am7amamsy/Minesweeper_Competition/README.md

Detection of mines in unexplored environments using a robot controlled via wireless piloting
This repository contains the codes used in detection, actuation, and communication of the robot.

(This project still needs extra documentation)
