am7amamsy/Minesweeper_Competition/Documents/Mega_Shield_Design.PNG

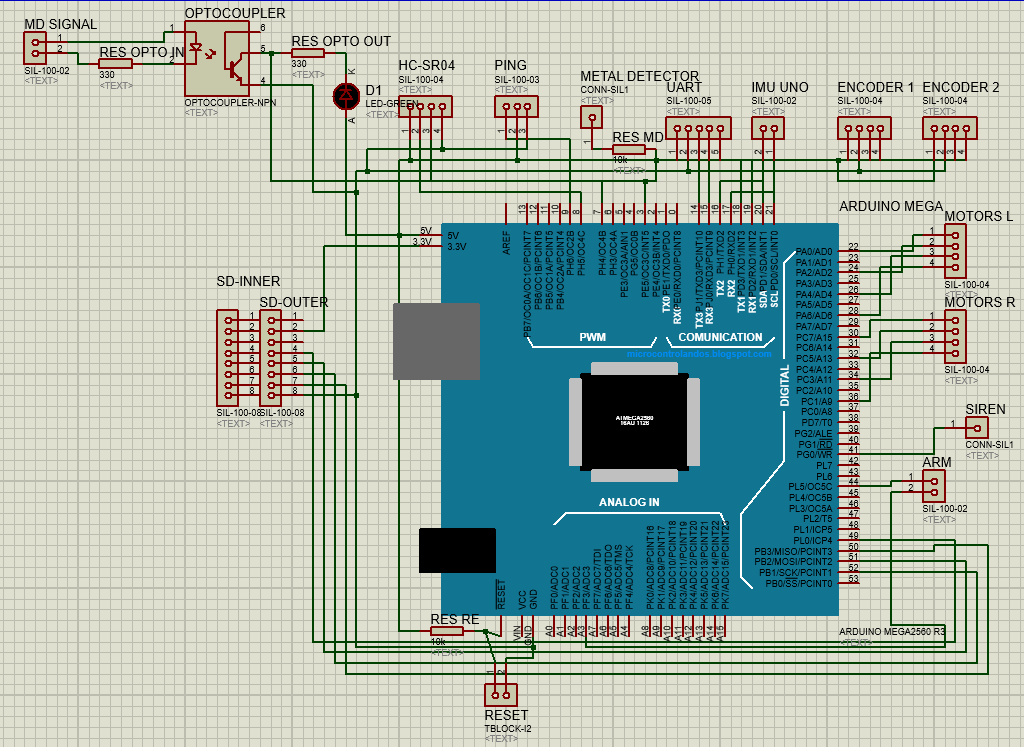
Documents/Mega_Shield_Design.PNG
