am7amamsy/Minesweeper_Competition/Documents/Mega_Shield_PCB.PNG

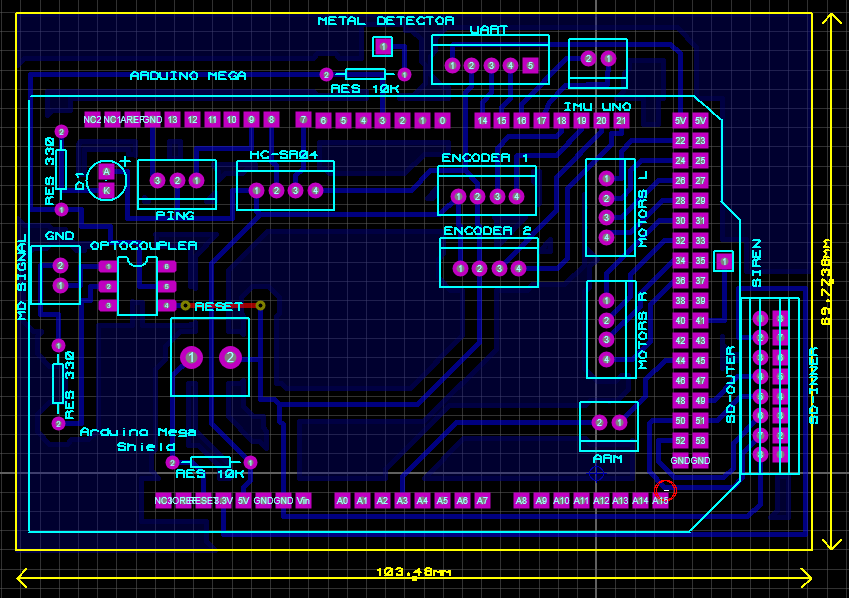
Documents/Mega_Shield_PCB.PNG
