am7amamsy/Minesweeper_Competition/Documents/Metal_Detector_Design.PNG

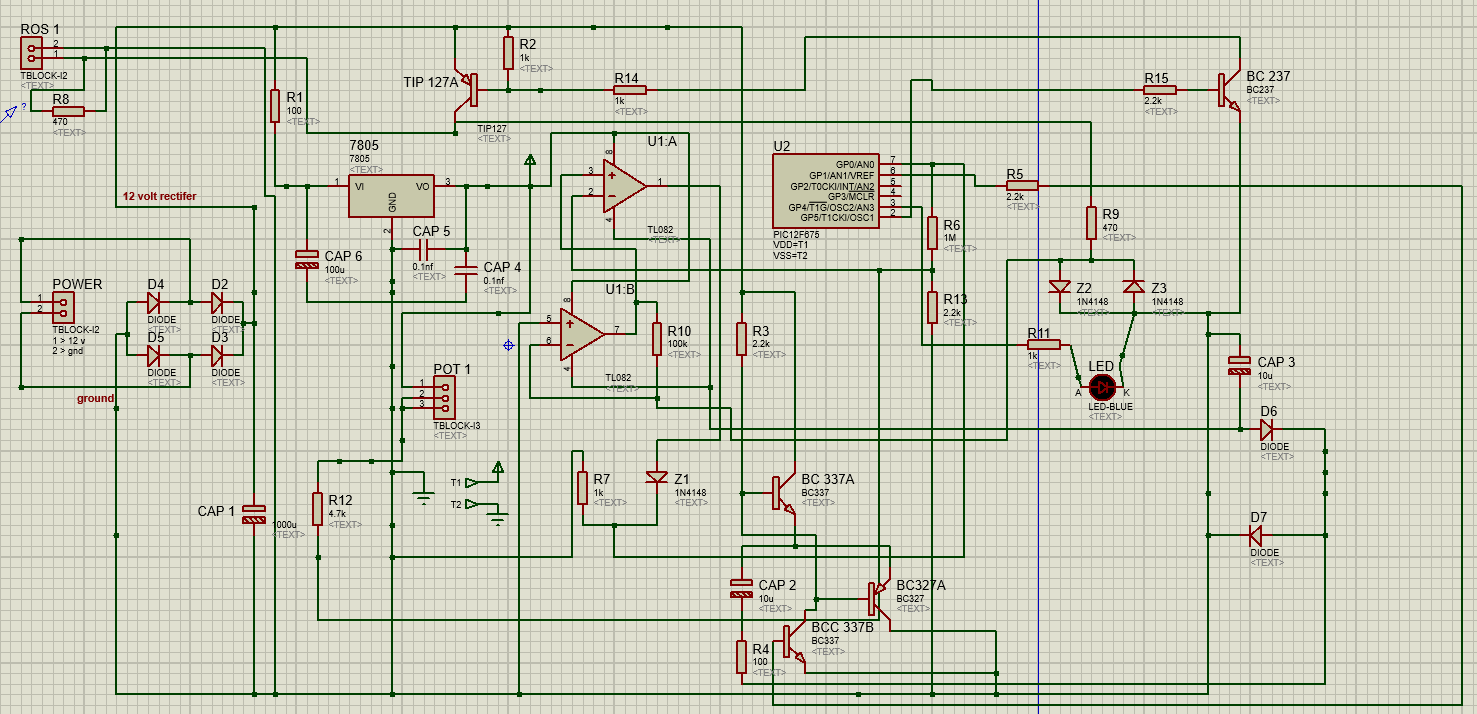
Documents/Metal_Detector_Design.PNG
