am7amamsy/Minesweeper_Competition/Documents/Metal_Detector_PCB.PNG

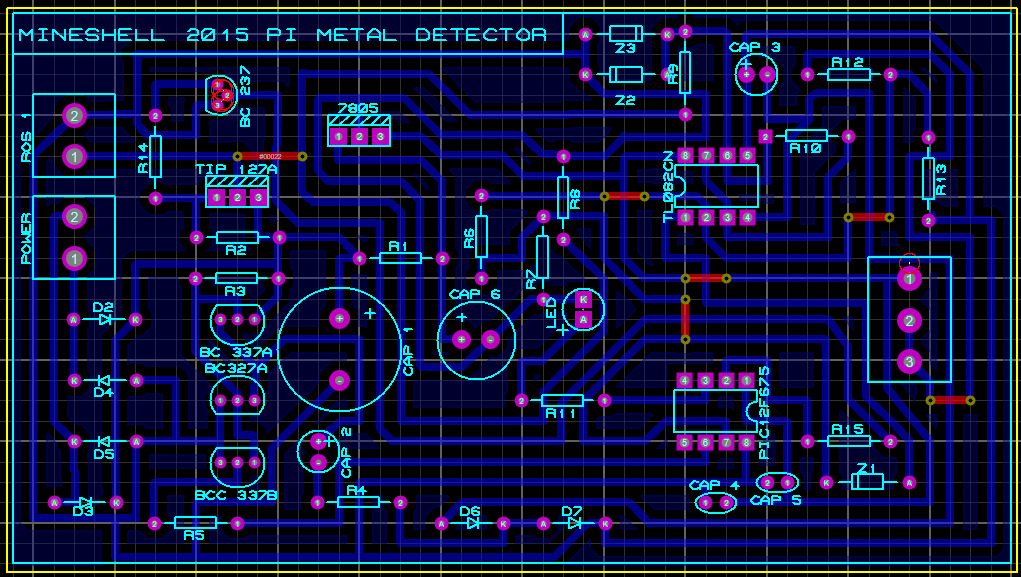
Documents/Metal_Detector_PCB.PNG
