am7amamsy/Minesweeper_Competition/(list of files, drawings)

Other design files:
Documents/Mega_Shield.DSN
Documents/Metal_Detector.DSN
