am7amamsy/Minesweeper_Competition/(commit log)

2022-10-08 Backlog for the minesweeper competition codes and designs
    [Mega_Shield.DSN, Metal_Detector.DSN]
2022-10-08 Changed proteus documentation files to images
    [Mega_Shield.DSN, Metal_Detector.DSN]
